ivan-divan/wirelessbuzzer/Controller Schematic.png

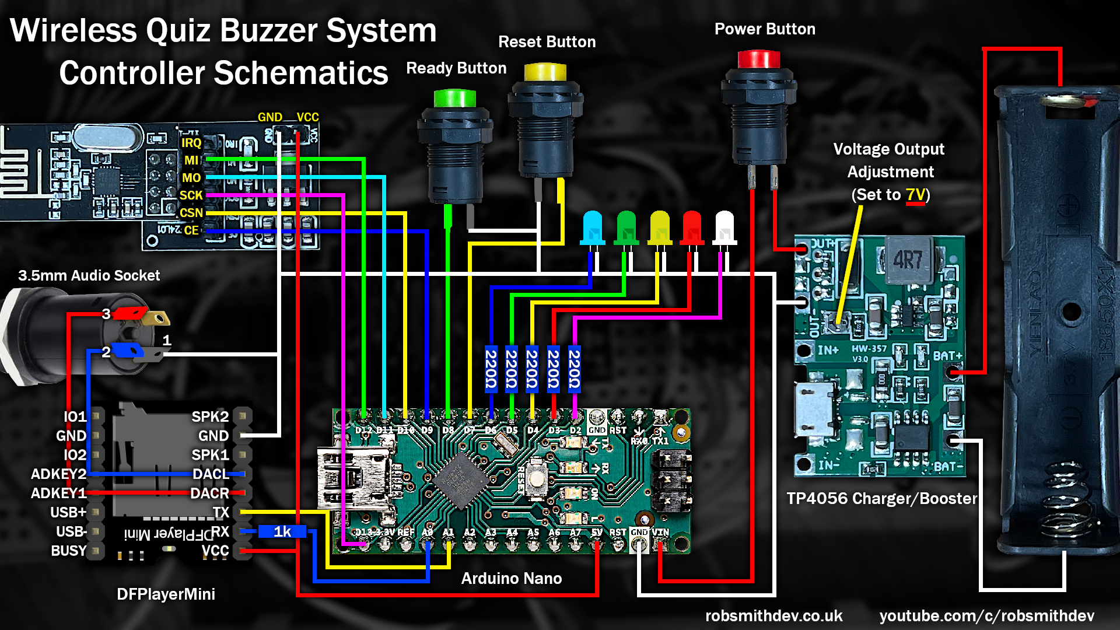
Controller Schematic.png
