ivan-divan/wirelessbuzzer/Buttons Schematics.png

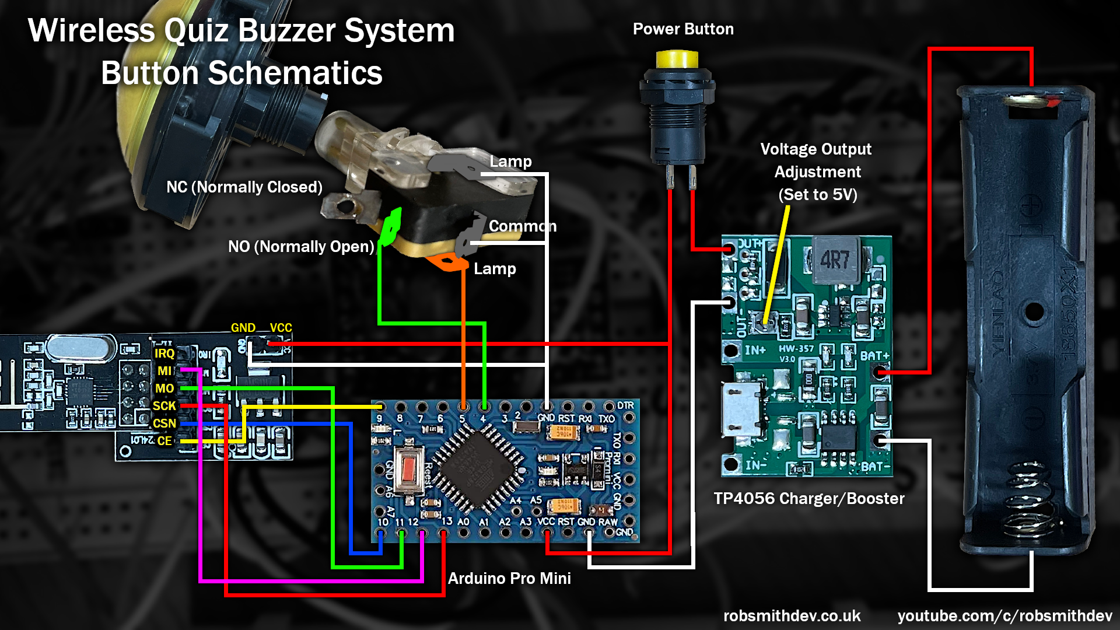
Buttons Schematics.png
