ivan-divan/wirelessbuzzer/readme.txt

Wireless Quiz Buzzer System using Arduino and nRF24L01!
-------------------------------------------------------

This is a wireless quiz buzzer system to help work out who answered first when running a quiz.
It can also offer further attempts to anyone who hasn't previously answered!

Tip: If you have any problems with the DFPlayerMini, power it from the Arduino's 3.3v pin rather than 5v.
Also, if you have issues with the buttons connecting to the controller, power everything off, then power up the controller first for a few seconds.

For more details visit see the video at https://youtu.be/b3iqji1DUG0

https://www.youtube.com/c/RobSmithDev
https://robsmithdev.co.uk

Tinkercad: https://www.tinkercad.com/things/k7JUDiFv1wr?sharecode=BaPiGkdqKju71d5xkFrCgnxJhQCo4WVAP1QIDcCe1sk
Thingiverse: https://www.thingiverse.com/thing:5396155

Products used in the video: (affiliate links)
nRF24L01+: https://amzn.to/3GxN7Hz (x10), https://amzn.to/3LLdtqn (x5)
nRF24L01+PA+LNA (Longer Range): https://amzn.to/3lKRe9i
nRF24L01+ 8-Pin Adapter: https://amzn.to/3z2A4Mi
TP4056 Based Charge/Boost Converter: https://amzn.to/3sYHXyx or https://amzn.to/3sWtLGt
18650 Battery Compartment: https://amzn.to/3GgvOdI
Arduino Pro Mini (16Mhz, 5V): https://amzn.to/3x8pnFF
FT232RL USB to TTL Converter (for programming the Arduino): https://amzn.to/3wLZRpf
Official Arduino Nano (Recommended): https://amzn.to/3FVaEBX
Arduino Nano (CH340 Version): https://amzn.to/3L3FLfv
DFPlayer Mini: https://amzn.to/38t9dOx
Red 10cm (4 inch) Arcade Button: https://amzn.to/39QotoZ
Yellow 10cm (4 inch) Arcade Button: https://amzn.to/38ueTI2
Green 10cm (4 inch) Arcade Button: https://amzn.to/3PgEMf6
Blue 10cm (4 inch) Arcade Button: https://amzn.to/3sx4jaa
Smaller Arcade Buttons (6cm) Alternative: https://amzn.to/3L8IT9Y
5V LED Lamps: https://www.arcadeworlduk.com/products/awuk-5v-10mm-wedge-base-led.html (not a sponsor)
M3 10mm Countersunk Screws: https://amzn.to/3MejVqM
M3 Metal Threadded Screw Inserts: https://amzn.to/3rgwhqB
Red PLA Plastic Filament: https://amzn.to/3yz7Bh2
Yellow PLA Plastic Filament: https://amzn.to/3swjccU
Green PLA Plastic Filament: https://amzn.to/37Ez45K
Blue PLA Plastic Filament: https://amzn.to/3yvmdxS
Spade Connectors: https://amzn.to/3w7GpUQ
Assorted 5mm LEDs: https://amzn.to/3LMT3gD
Plastic Chrome LED Panel Mount Holder: https://amzn.to/39Qnrtf
Assorted Resistors: https://amzn.to/3MRX6th
Wire Stripping Tool: https://amzn.to/321om6g

Arduino Libraries Used:
nRF24: https://github.com/nRF24/RF24
DFPlayer Mini Arduino Library: https://github.com/DFRobot/DFRobotDFPlayerMini
DFPlayer Mini Information: https://wiki.dfrobot.com/DFPlayer_Mini_SKU_DFR0299
