ivan-divan/wirelessbuzzer/Finished System.jpg

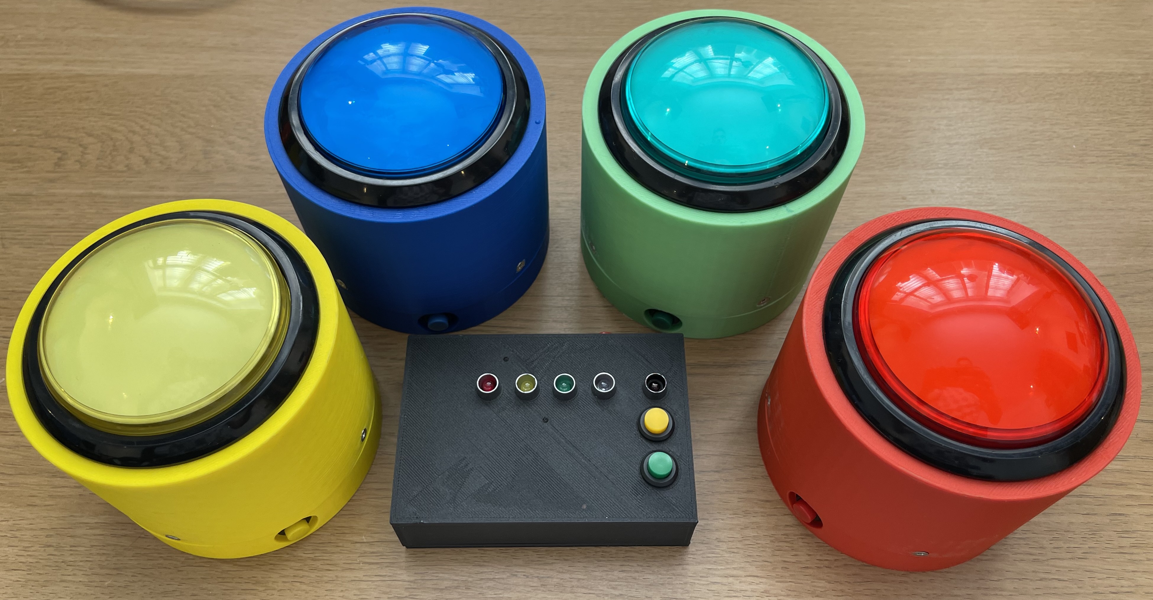
Finished System.jpg
