ivan-divan/wirelessbuzzer/Title.jpg

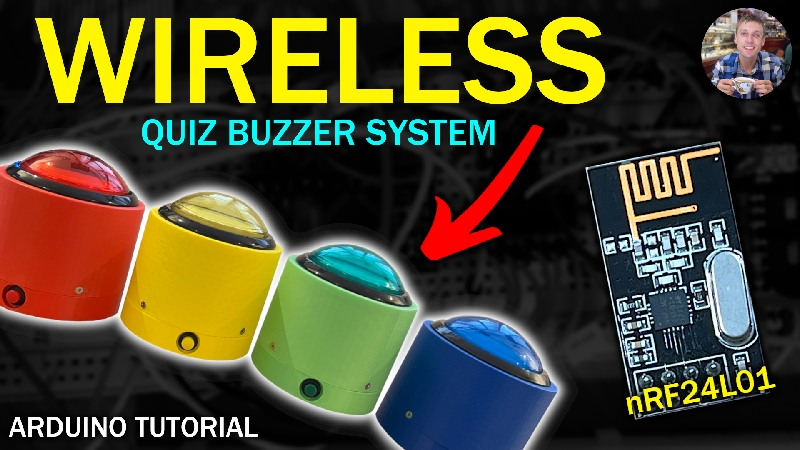
Title.jpg
